OpenwaterHealth/opw_ustx/embedded/README.md

# Openwater USTX Embedded Repository

## Overview

The Openwater USTX Embedded repository is the firmware for the the USTX embedded hardware based on a ST Microelectronics STM32F446 MCU and Texa Instruments TX7332 ultrasound analog front-end (AFE), the USTX is capable of:

- Real-time signal processing: On-board processing for efficient data analysis and filtering.
- Reliable communication: Secure data transmission through various communication protocols.
- Flexible configuration: Adaptable to different underwater applications through software adjustments.

## Getting Started:

1. Clone the repository: git clone https://github.com/OpenwaterHealth/opw_ustx.git
2. Install dependencies: https://www.st.com/en/development-tools/stm32cubeide.html
3. Build the firmware: Import the project source into the STM32 CubeIDE environment and compile the project firmware located in the embedded folder.

## Contribution Guide

For more information on how to contribute to the project, please refer to the [Contribution Guide](CONTRIBUTING.md).
