OpenwaterHealth/opw_ustx/hardware/USTX prototype.docx

USTX prototype

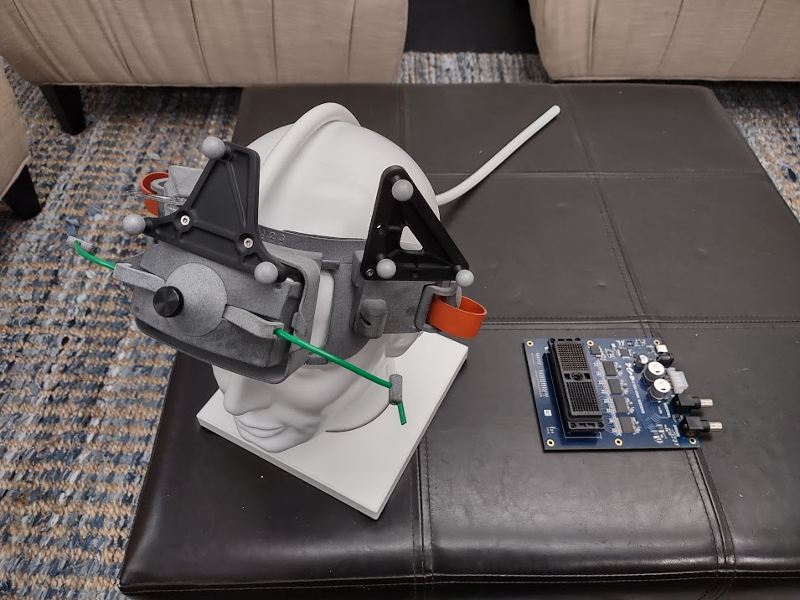
[picture p1: figure]

Figure 1

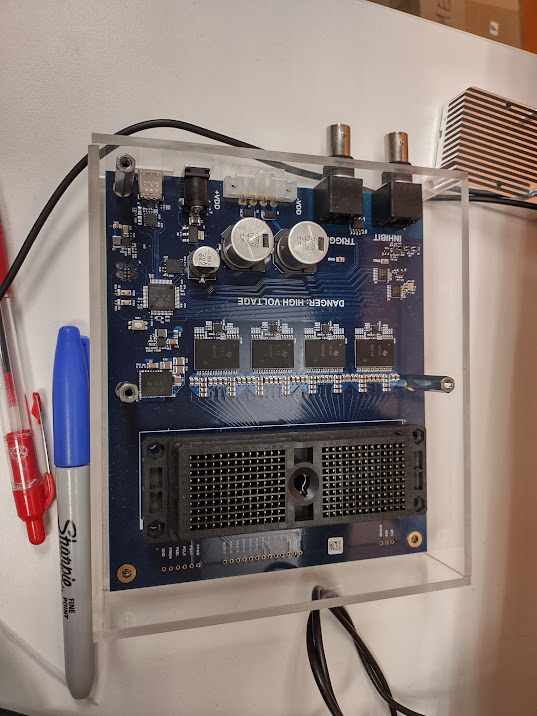
[picture p2: figure]

Figure 2

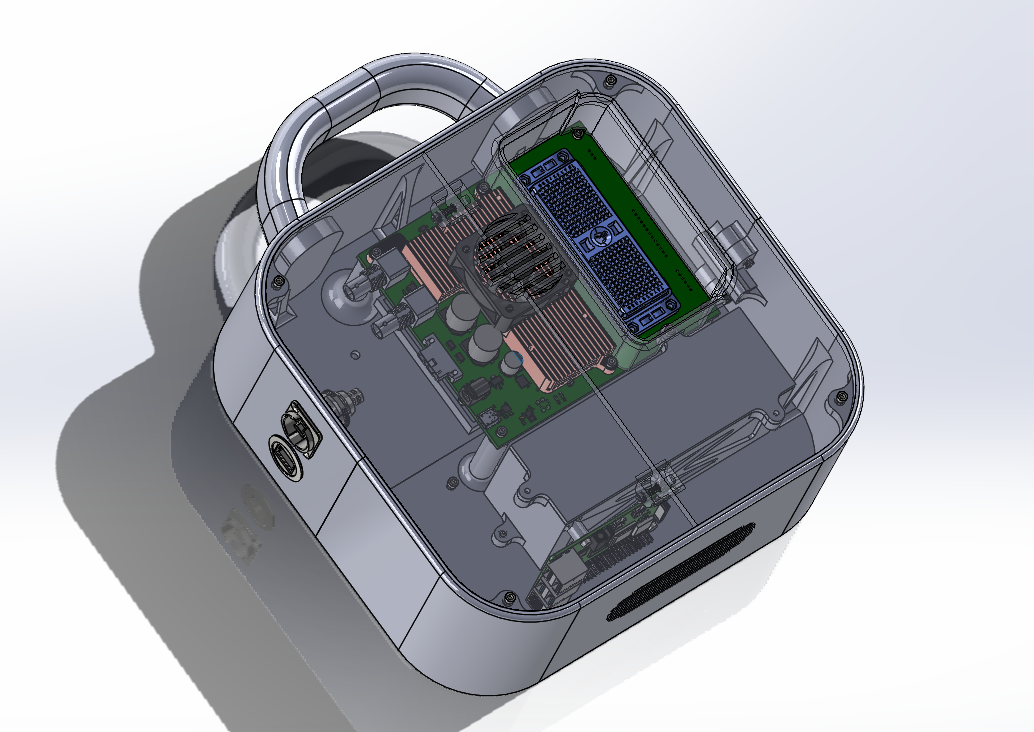
[picture p3: figure]

Figure 3

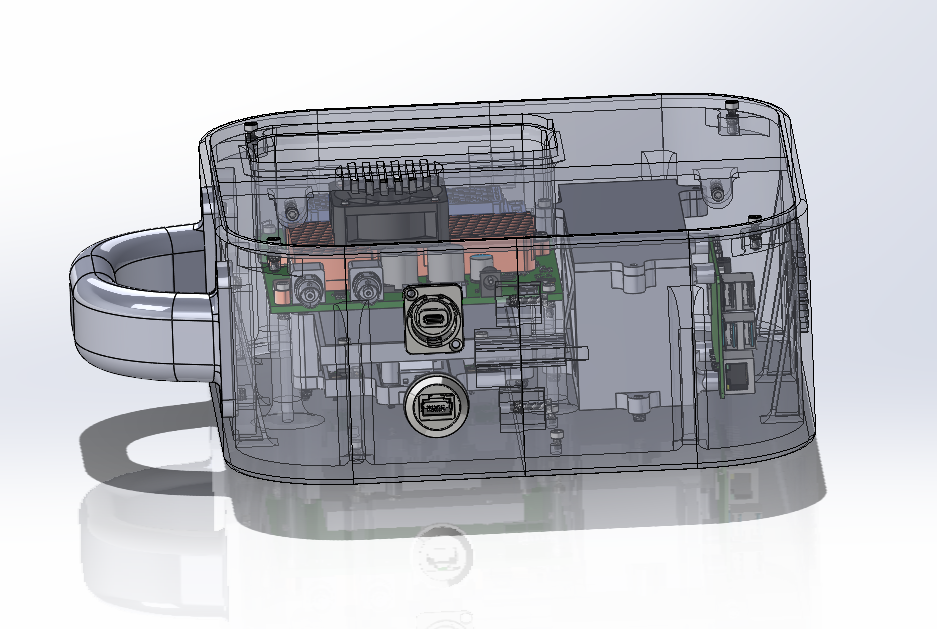
[picture p4: figure]

Figure 4

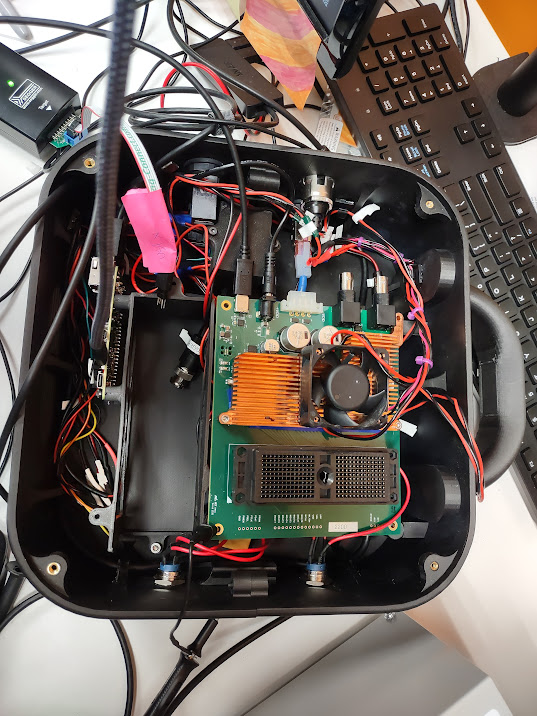
[picture p5: figure]

Figure 5 prototype

The USTX 1-2 .zip is the altium file download

Compact USTX driuper.zip is a compressed file with the native solidworks files

Compact USTX .step is a solid model of the assembly

Compact USTX.easm is a e-drawing or an assembly that can be opened with a free viewer
