OpenwaterHealth/opw_ustx/hardware/Schematic PDF_[No Variations].pdf

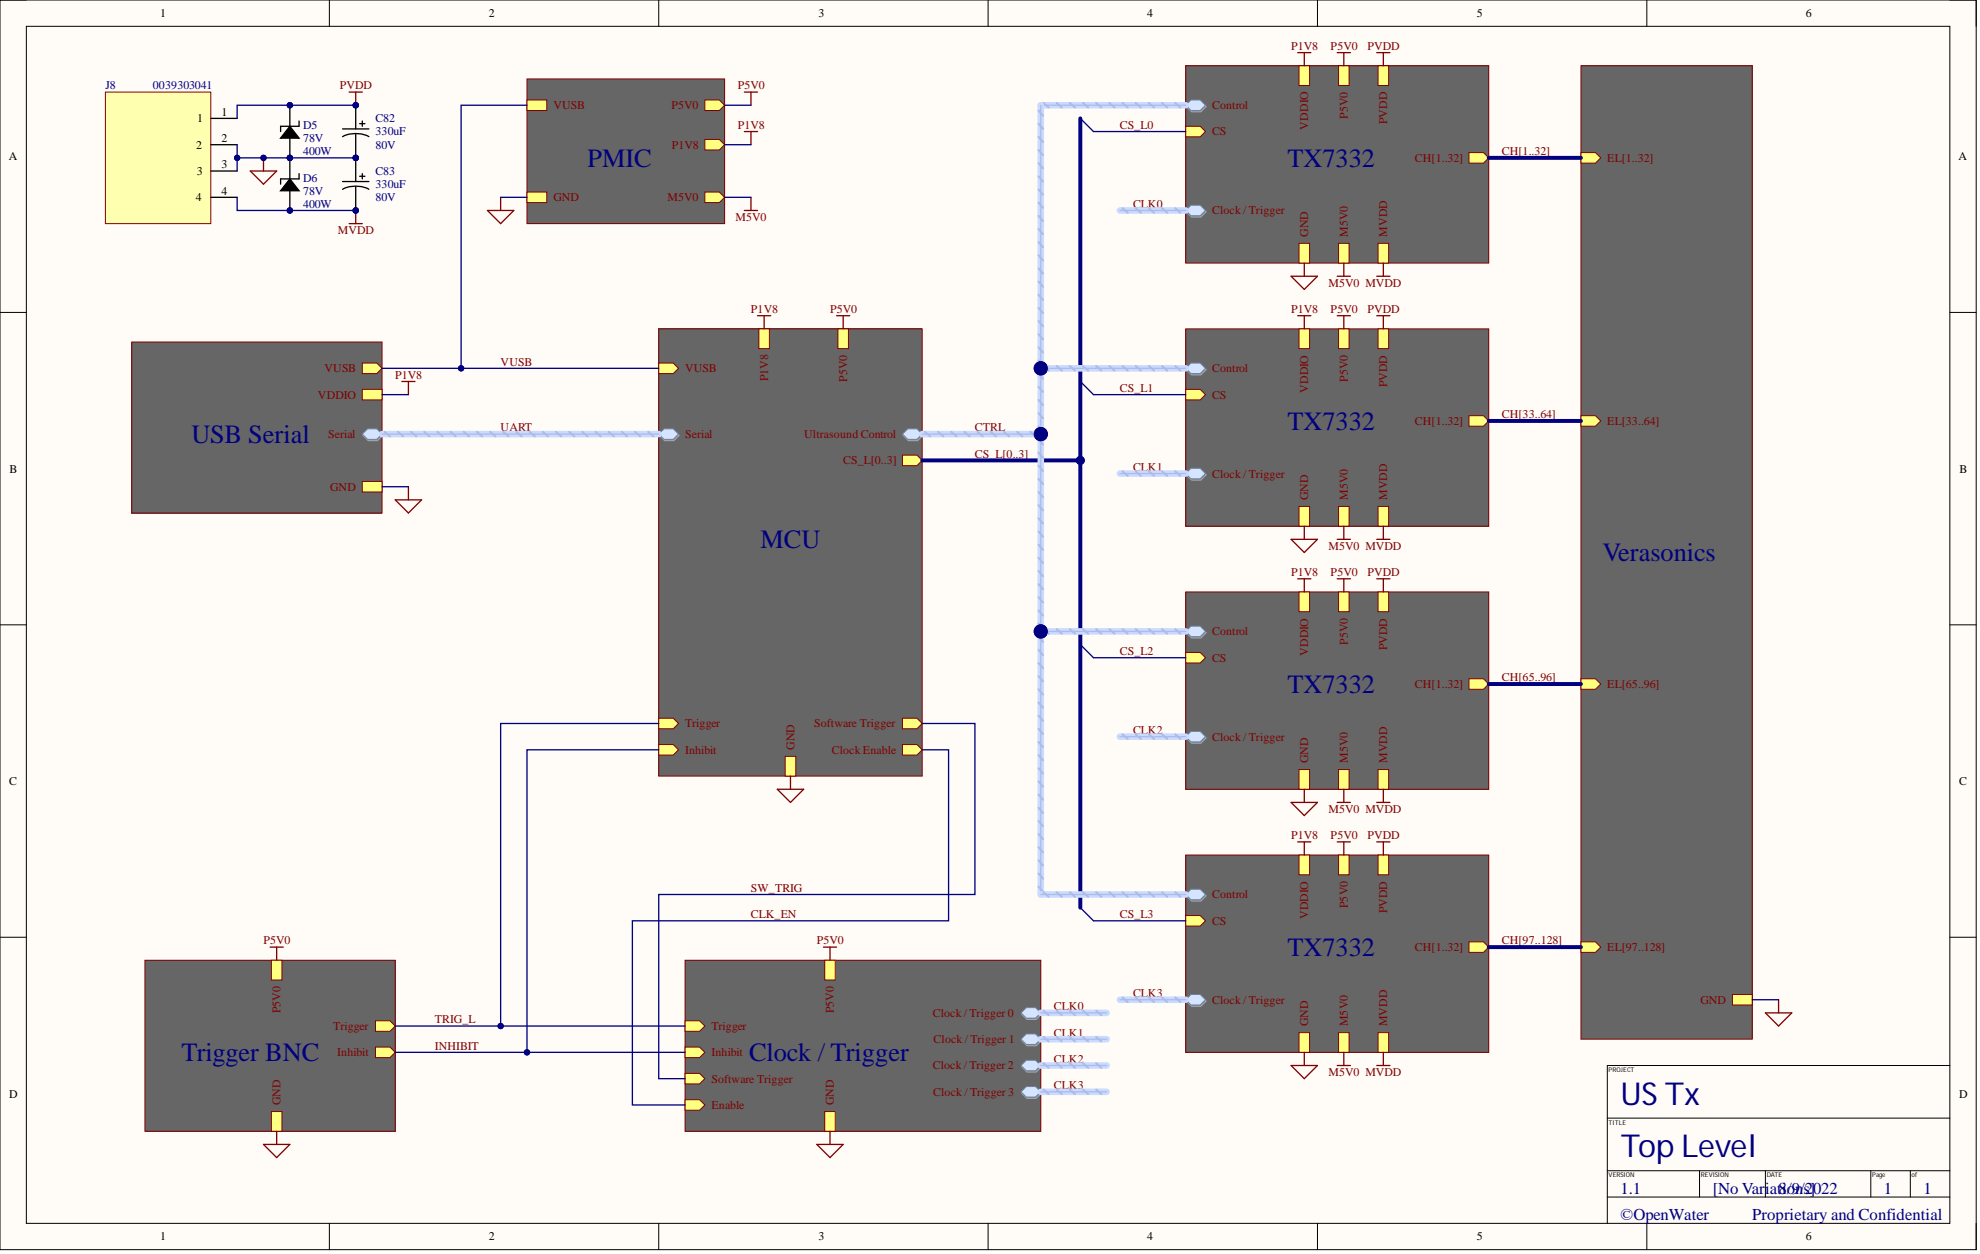
[picture p6: page 1]
Top Level; USB Serial; Ultrasound Control; Inhibit; Clock Enable; Software Trigger; Clock / Trigger; Inhibit rigger BNC; GND P5V0; Clock / Trigger 0; Clock / Trigger 1; Clock / Trigger 2; Clock / Trigger 3

[No Variations] DATE

Proprietary and Confidential

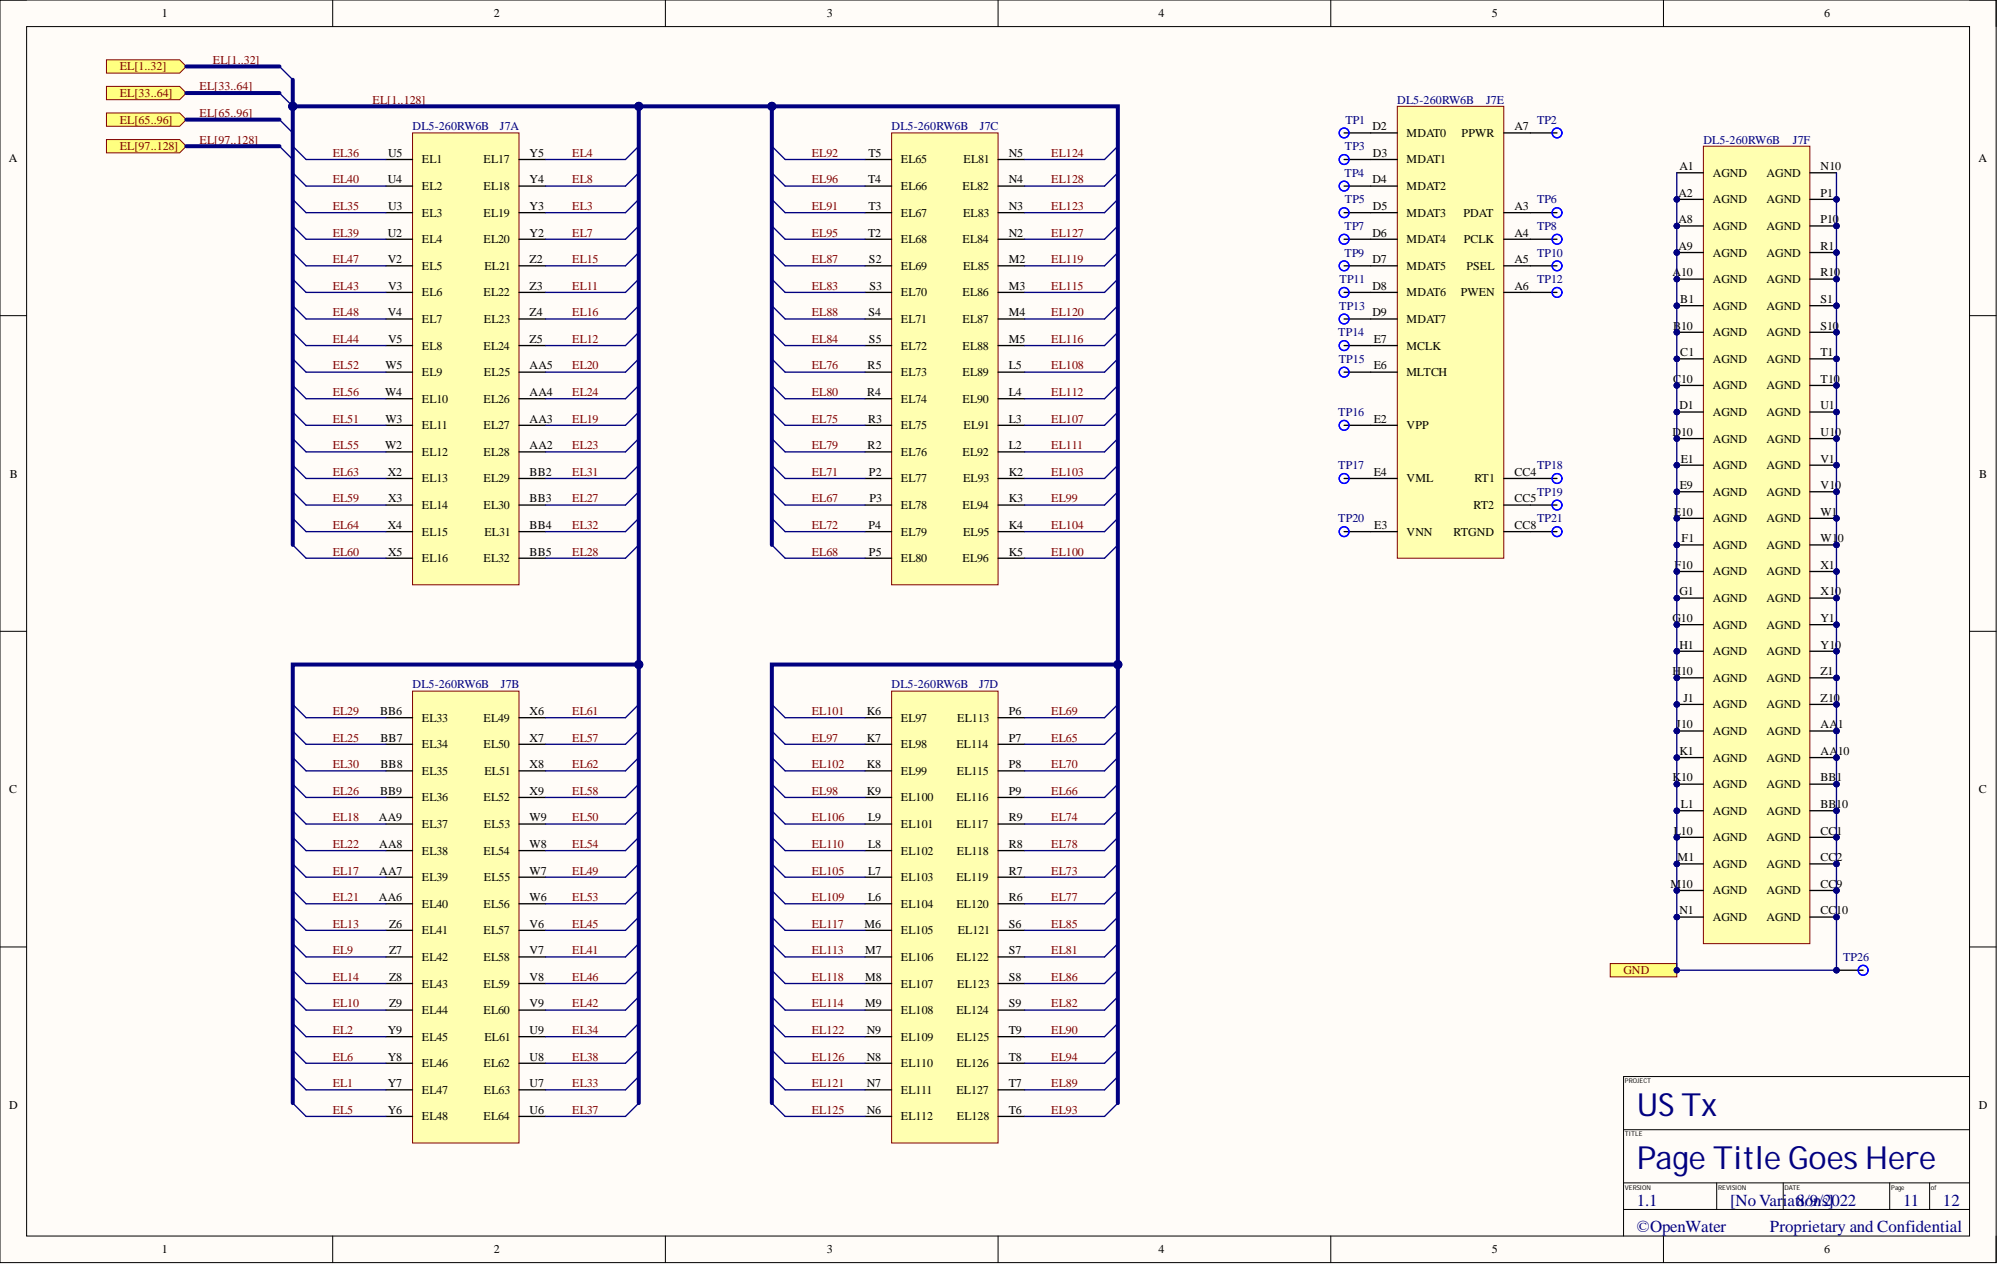
[picture p7: page 2]

PIJ70B10 | 0

PIJ70C1 | T 1

PIJ70C10 | T 1 | 0

PIJ70D1 | U 1

PIJ70D10 | U 1

PIJ70E1 | V 1

PIJ70E9 | V 1

PIJ70E10 | W 1

PIJ70F1 | W 1

PIJ70F10 | X 1

PIJ70G1 | X 1

PIJ70G10 | Y 1

PIJ70H1 | Y 1

PIJ70H10 | Z 1

PIJ70J1 PIJ70J1 PIJ70J10 PIJ70J10 | A A

PIJ70K1 | A A

TITLE
Page Title Goes Her

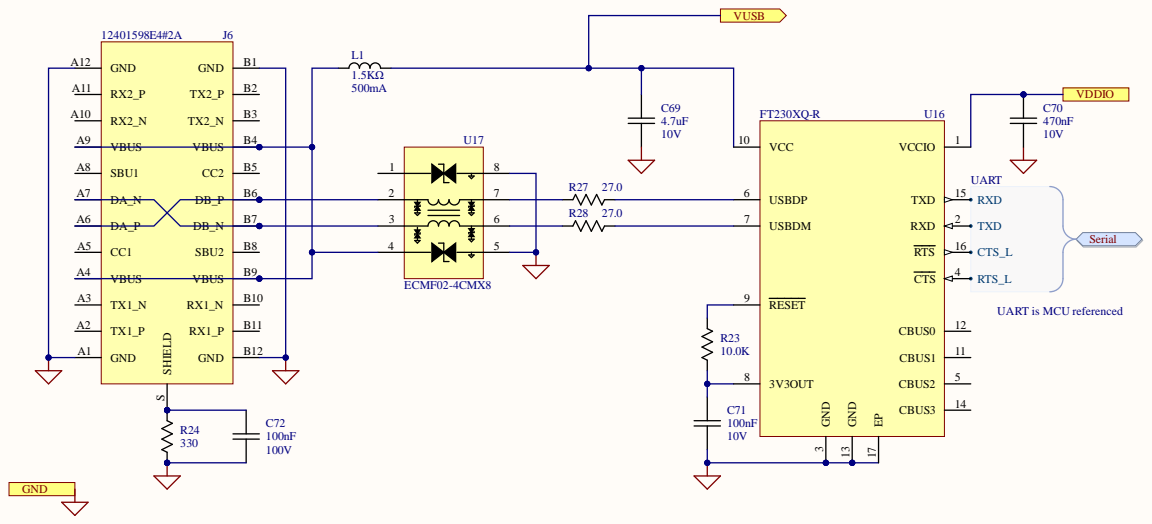
[picture p8: page 3]

UART is MCU referenced

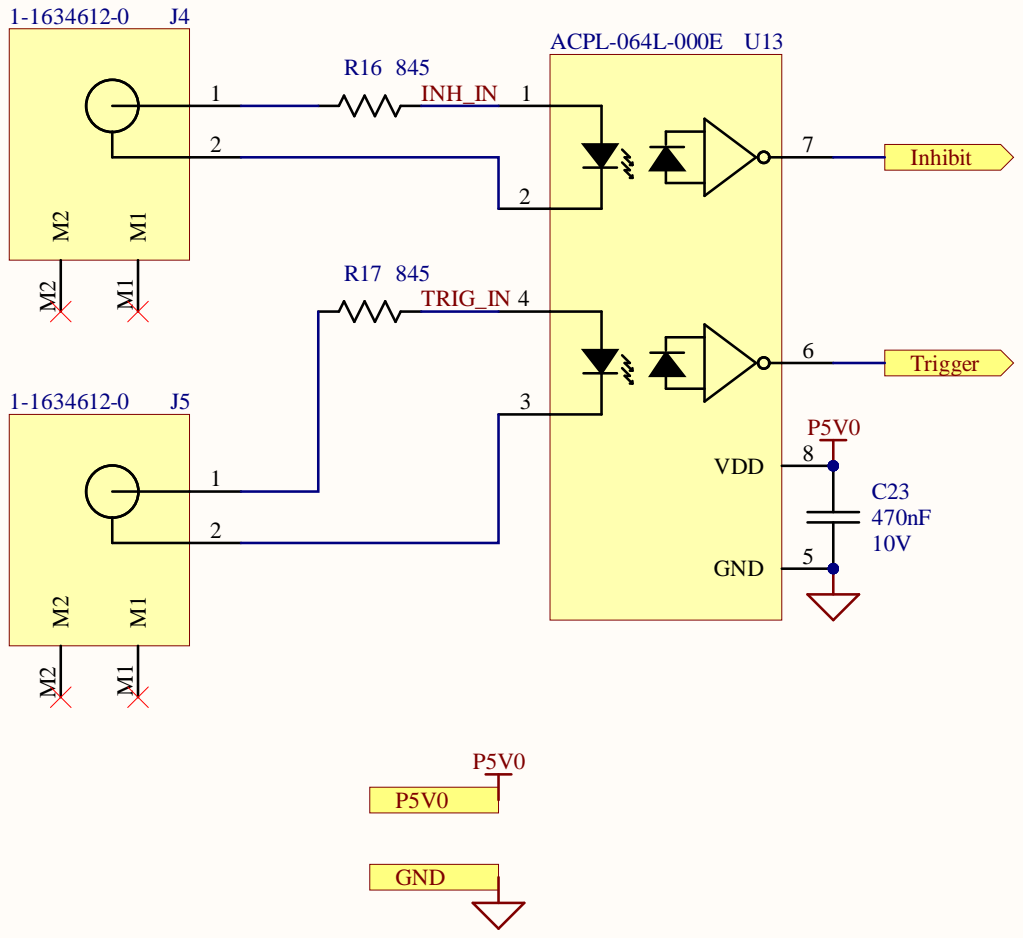
[picture p9: page 4]
Trigger In

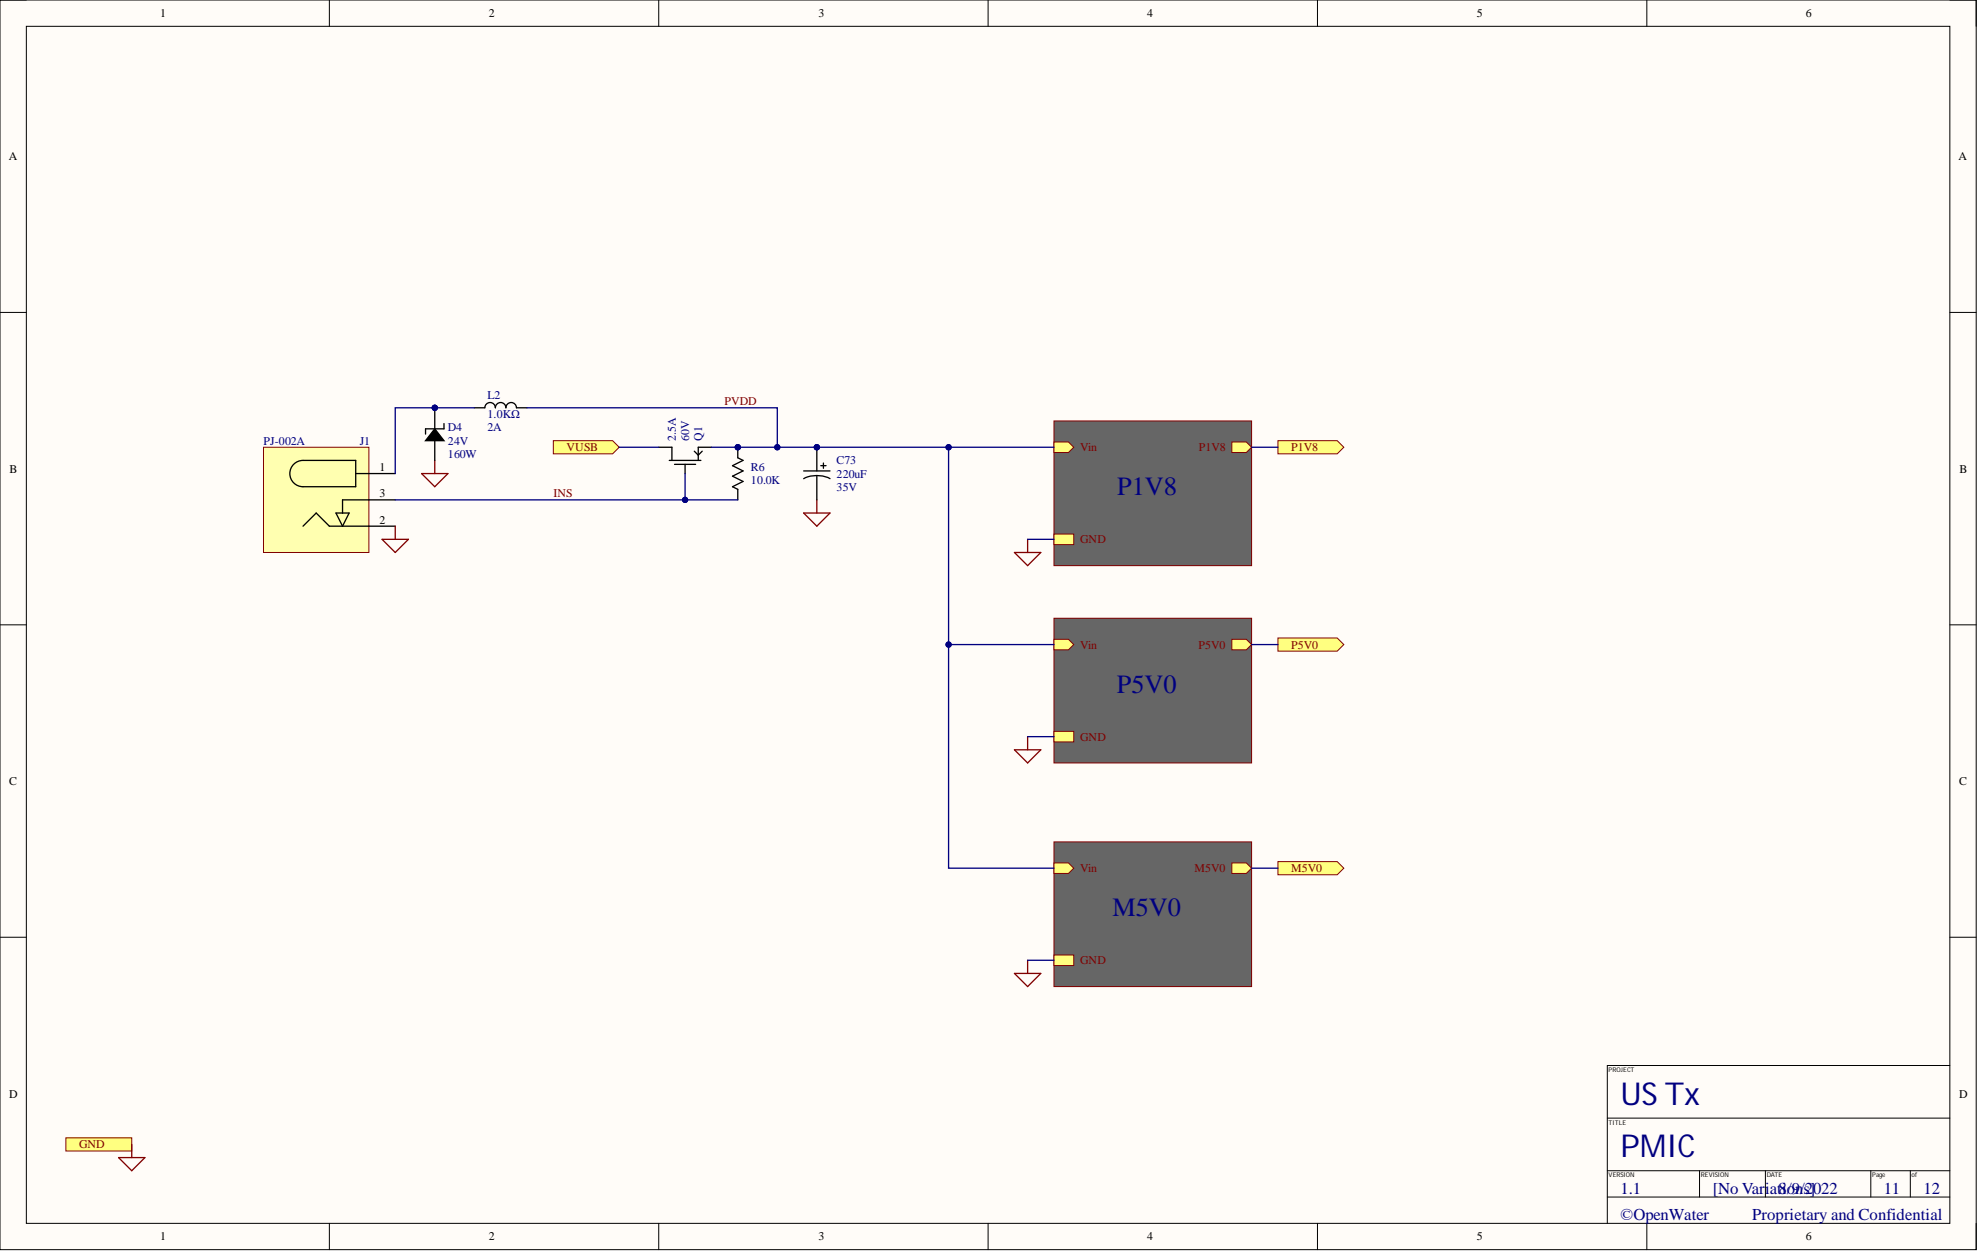
[picture p10: page 5]

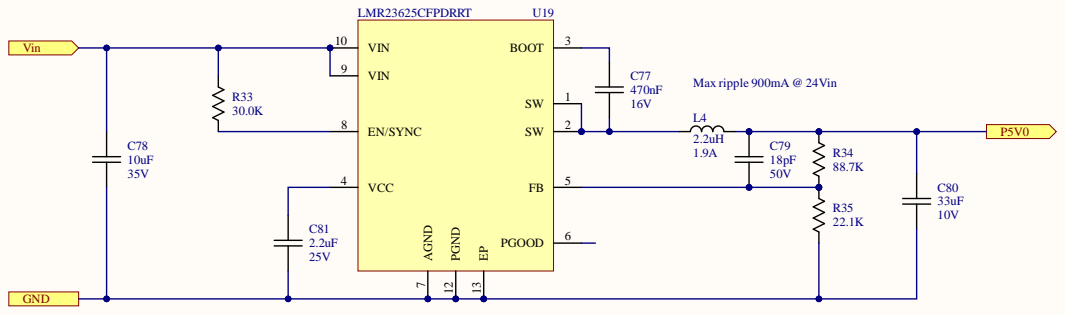
[picture p11: page 6]

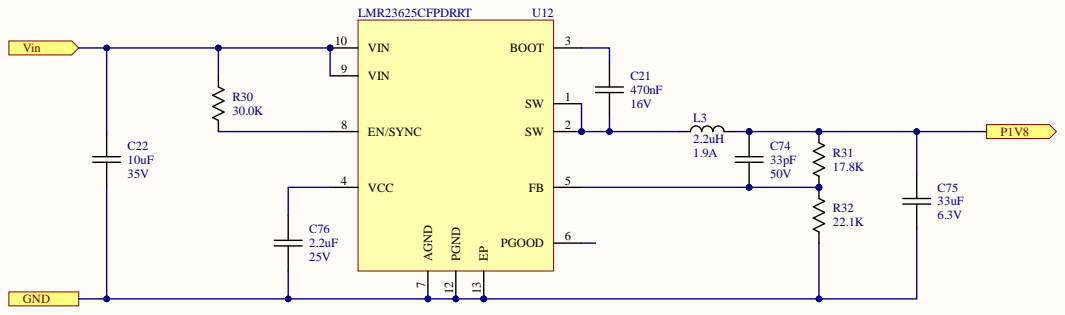
[picture p12: page 7]

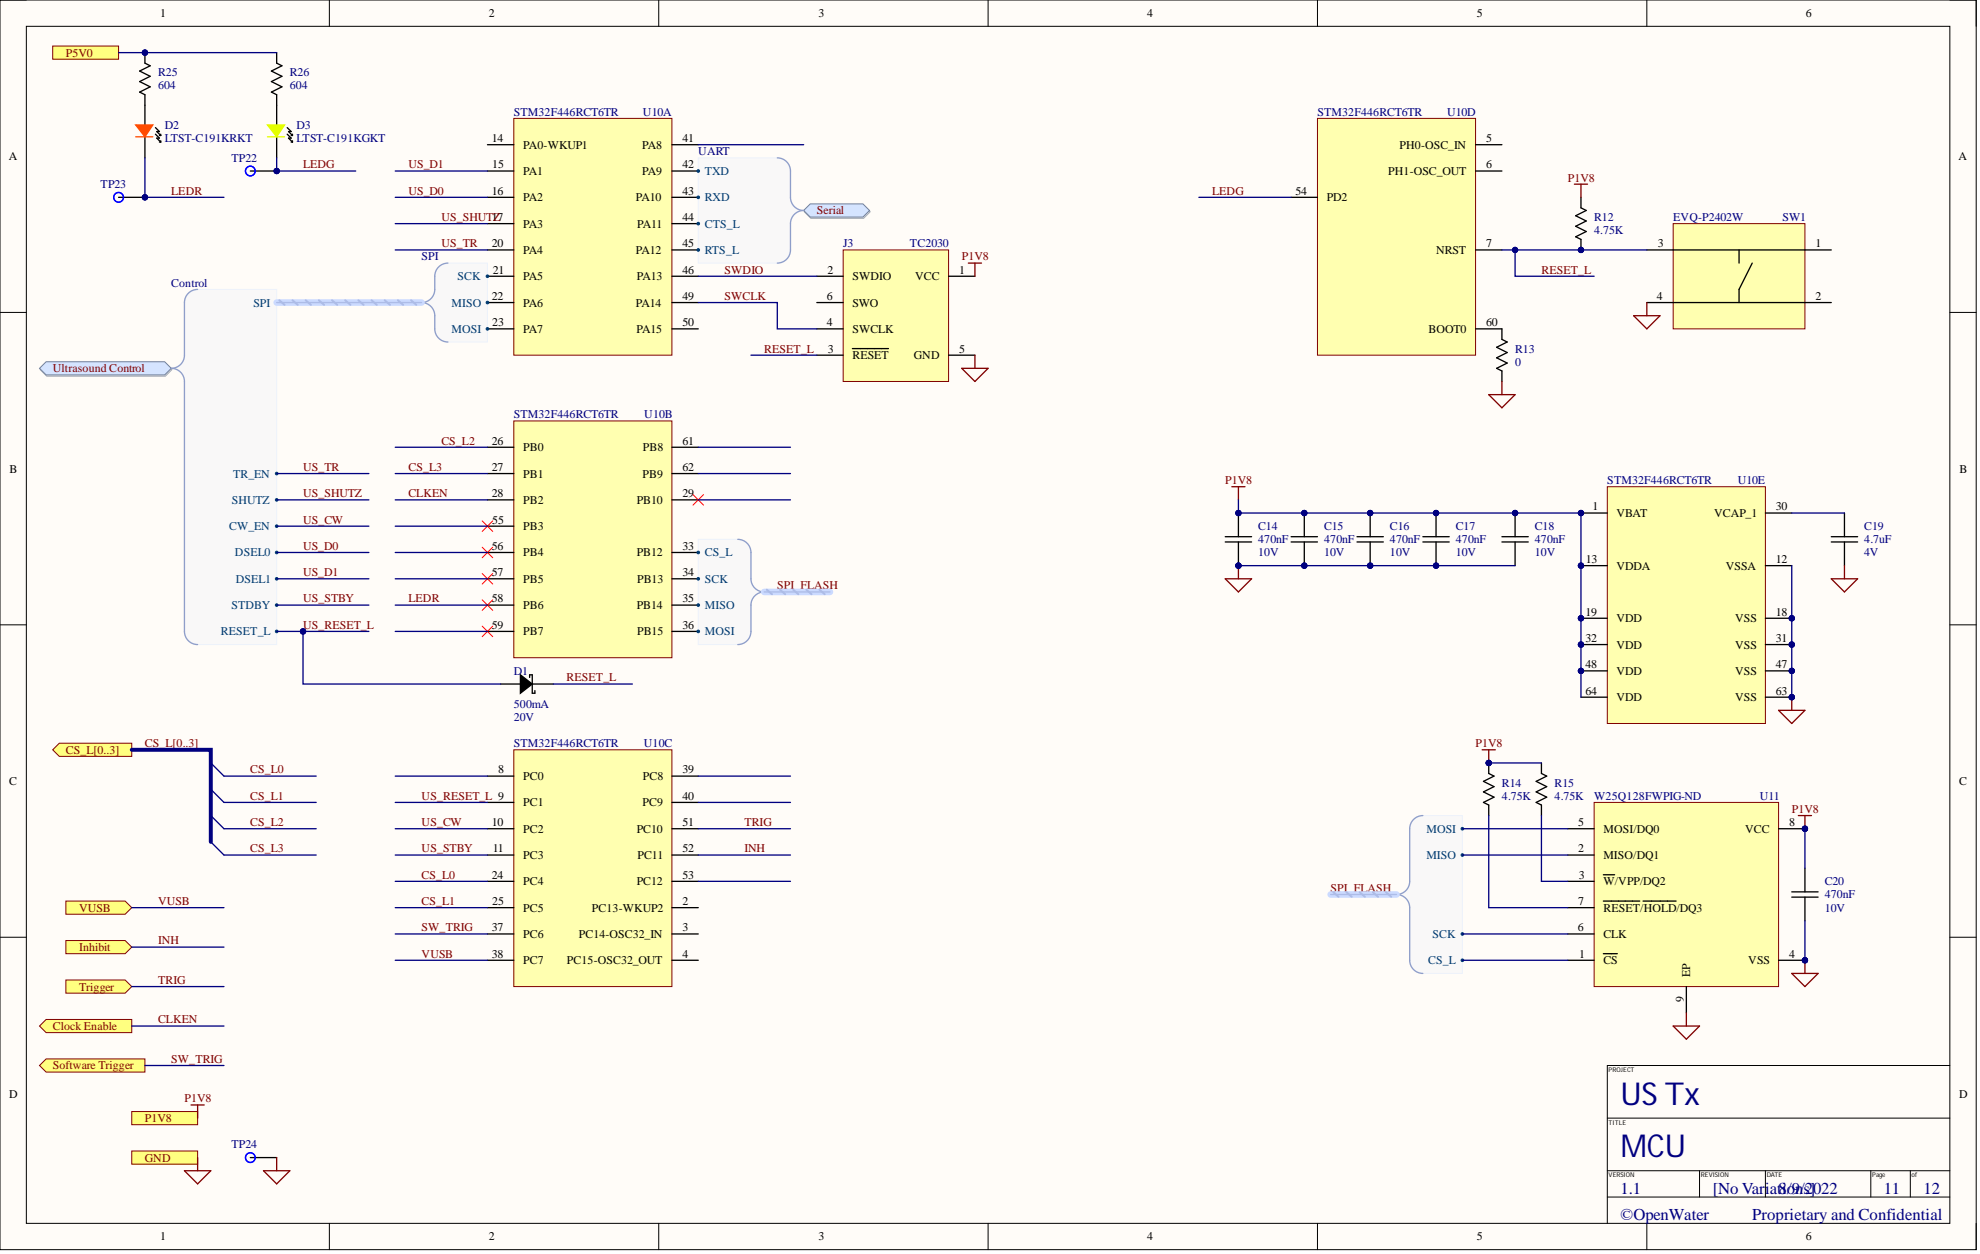
[picture p13: page 8]

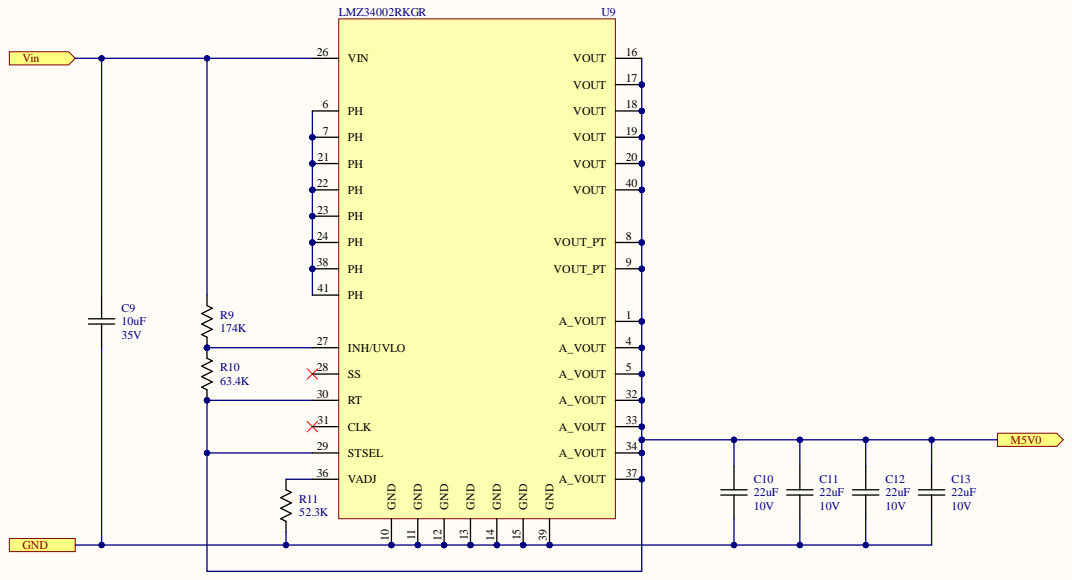
[picture p14: page 9]

CLK 31

VADJ 36

PROJECT
Page Title Goes Here

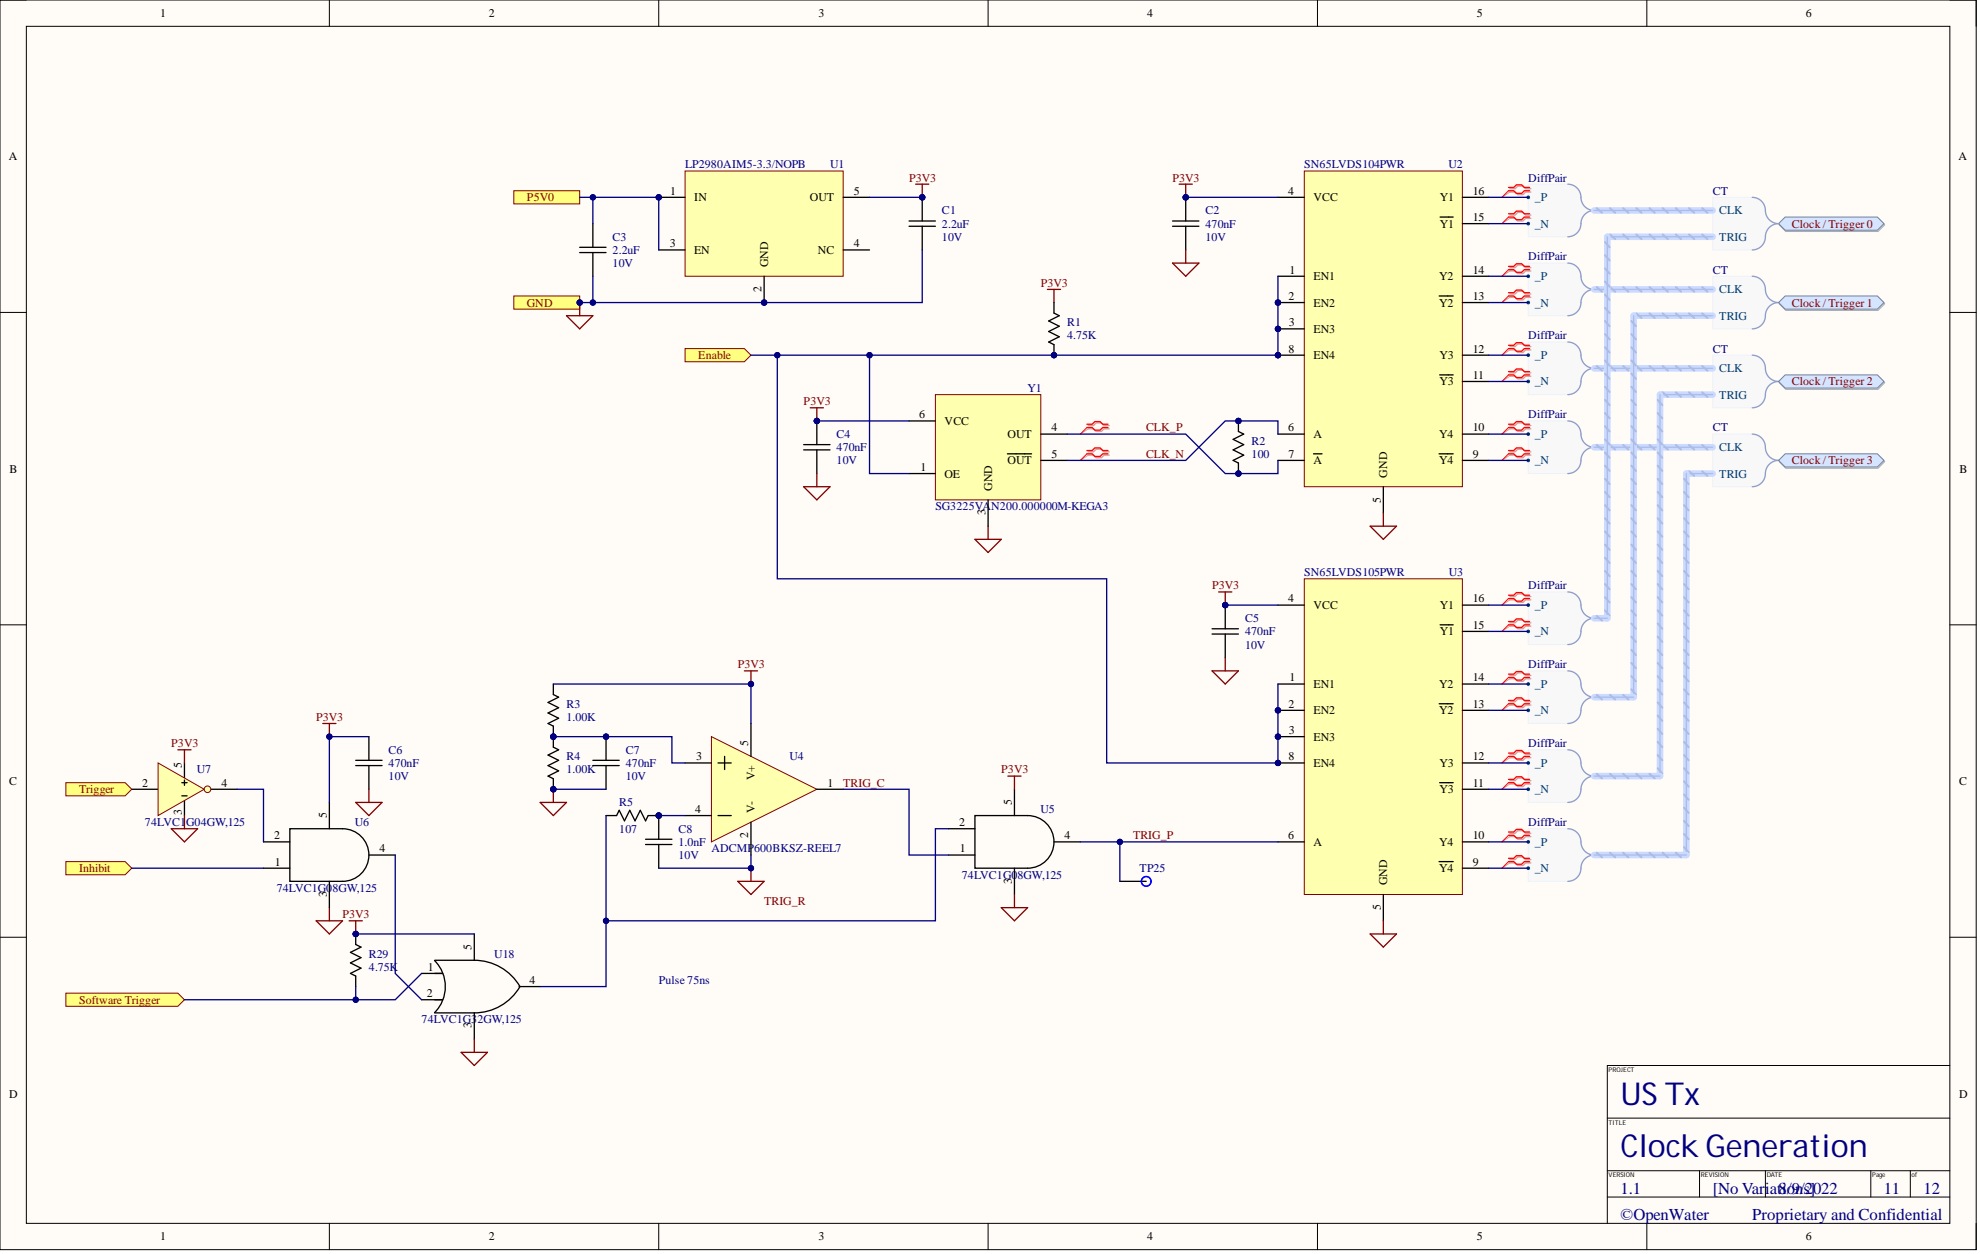
[picture p15: page 10]

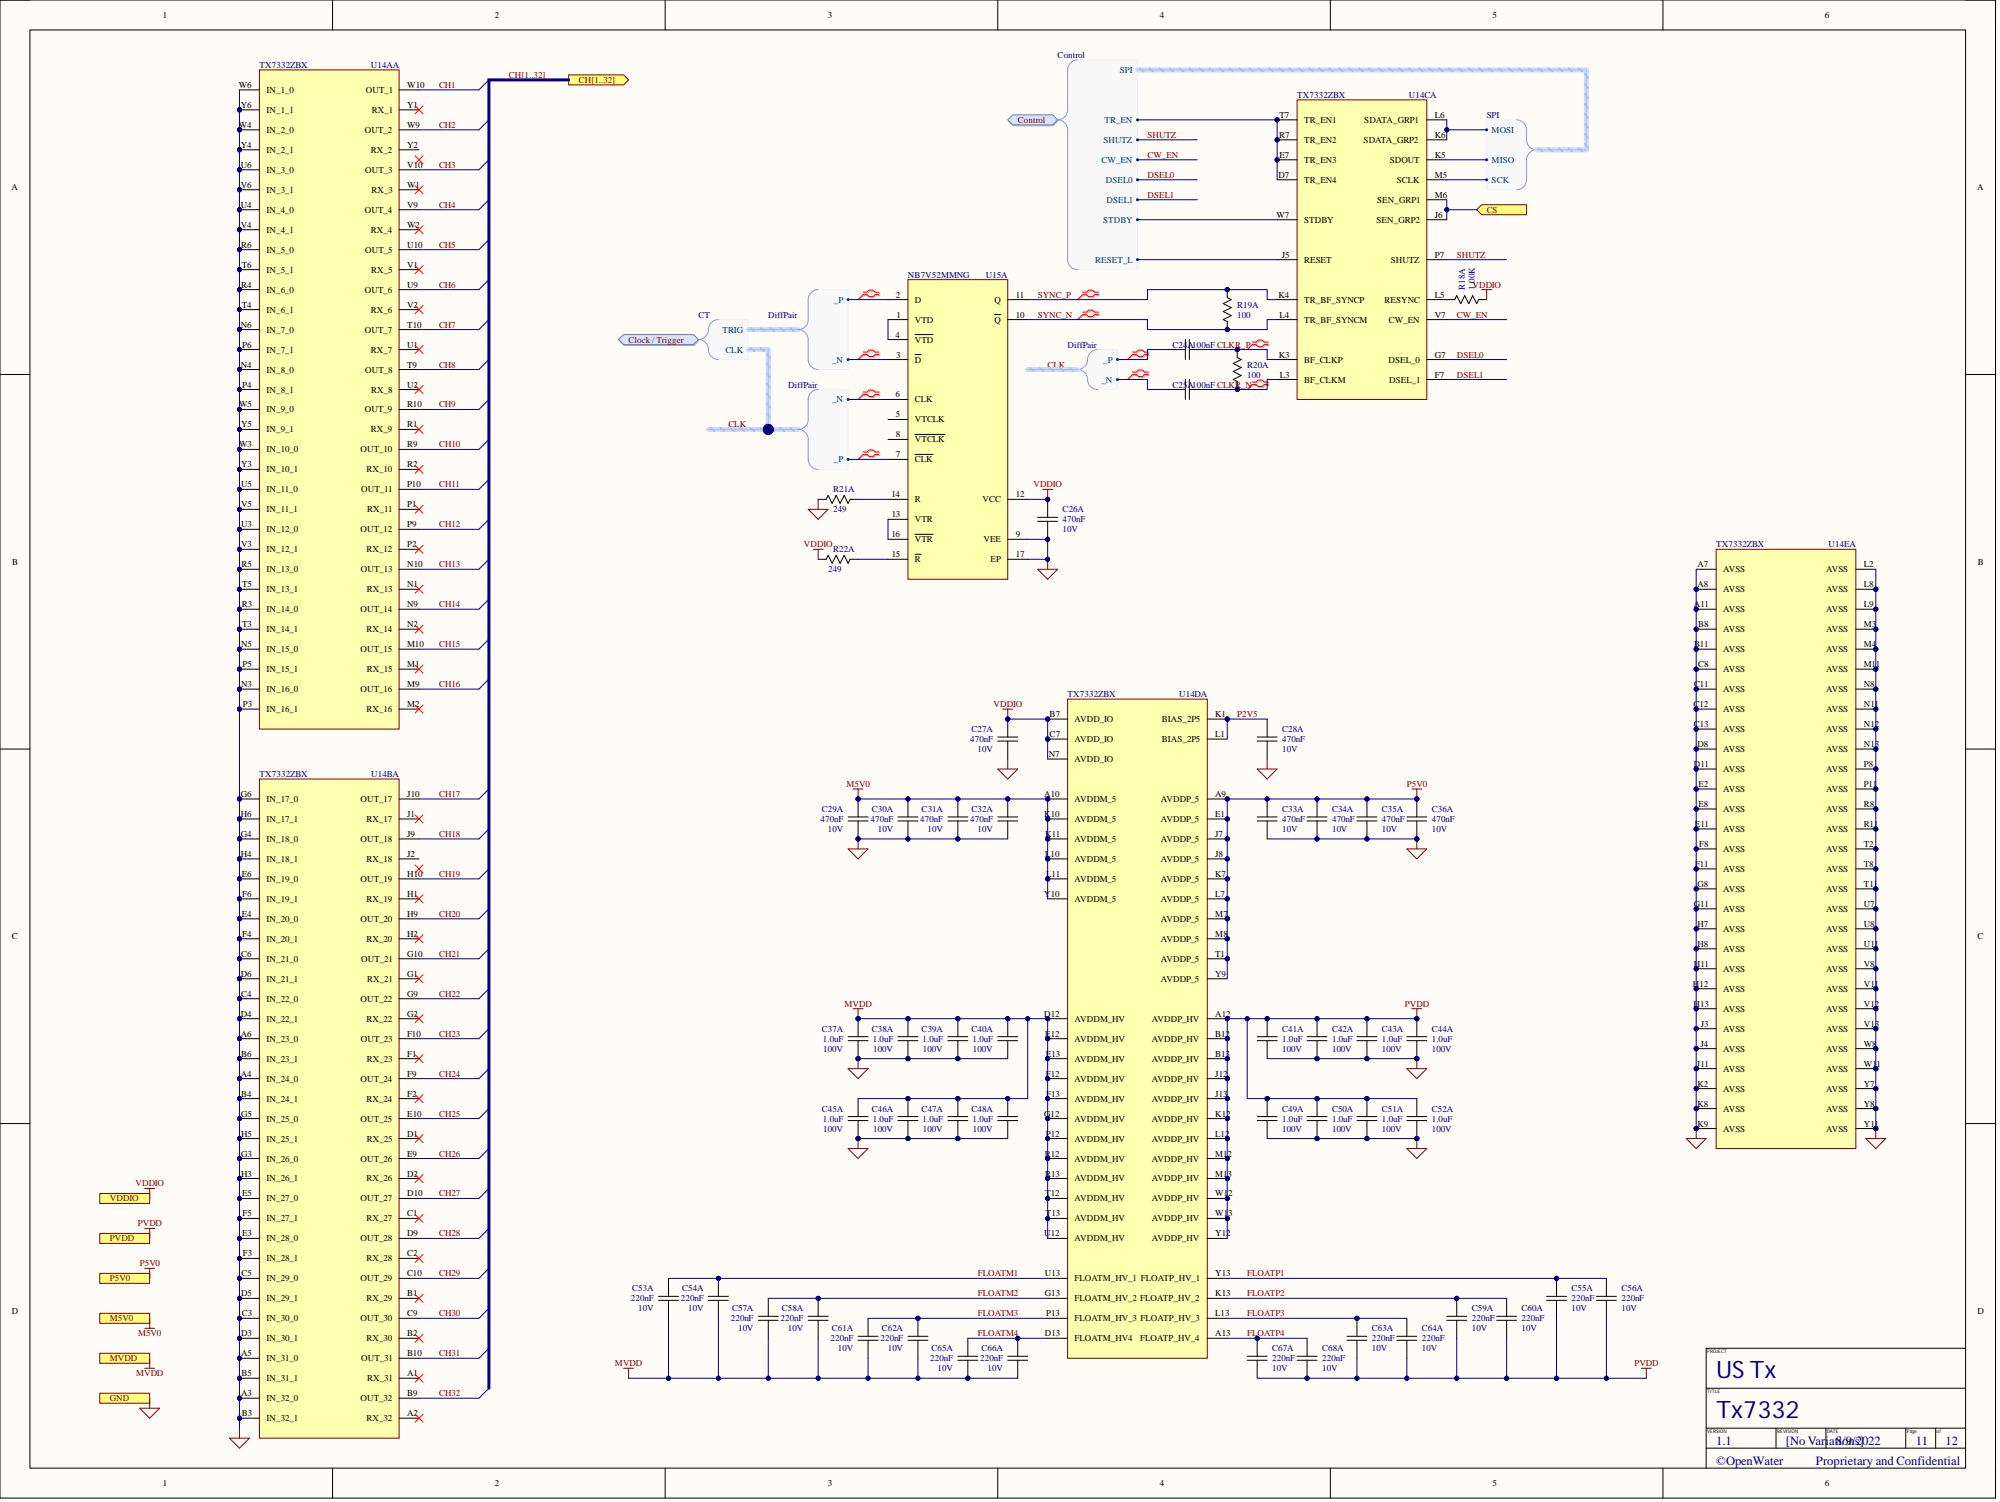
[picture p16: page 11]

POClock 0 Trigger0CLK00NA POClock 0 Trigger0CLK00PA POClock 0 Trigger0CLKA POClock 0 Trigger0TRIG00NA POClock 0 Trigger0TRIG00PA POClock 0 Trigger0TRIGA POClock 0 TriggerA

POClock 0 Trigger0CLK00NB POClock 0 Trigger0CLK00PB POClock 0 Trigger0CLKB POClock 0 Trigger0TRIG00NB POClock 0 Trigger0TRIG00PB POClock 0 Trigger0TRIGB POClock 0 TriggerB

PIU14A0C12 PIU14A0C12 PIU14B0C12 PIU14B0C12 | N 1 | 1

PIC27A01 PIC27A01 PIC27B01 PIC27B01 PIC27C01 | PIU14A0C7 PIU14A0C7 PIU14B0C7 PIU14B0C7 | L 1 | PIC28A01 PIU14A0K1 PIC28B01 PIU14B0K1

PIU14A0C13 PIU14A0C13 PIU14B0C13 PIU14B0C13 | N 1

PIC27A02 PIC27A02 PIC27B02 PIC27B02 PIC27C02 | | | PIC28A02 PIC28A02 PIC28B02 PIC28B02 PIC28C02

PIU14A0H8 PIU14A0H8 PIU14B0H8 PIU14B0H8 PIU14A0H11 PIU14A0H11 PIU14B0H11 PIU14B0H11 | V 8

PIU14A0H12 PIU14A0H12 PIU14B0H12 PIU14B0H12 | V 1 | 1

PIU14A0J4 PIU14A0J4 PIU14B0J4 PIU14B0J4 | W 1

PIU14A0J11 PIU14A0J11 PIU14B0J11 PIU14B0J11 PIU14A0K2 PIU14A0K2 PIU14B0K2 PIU14B0K2 | Y 7

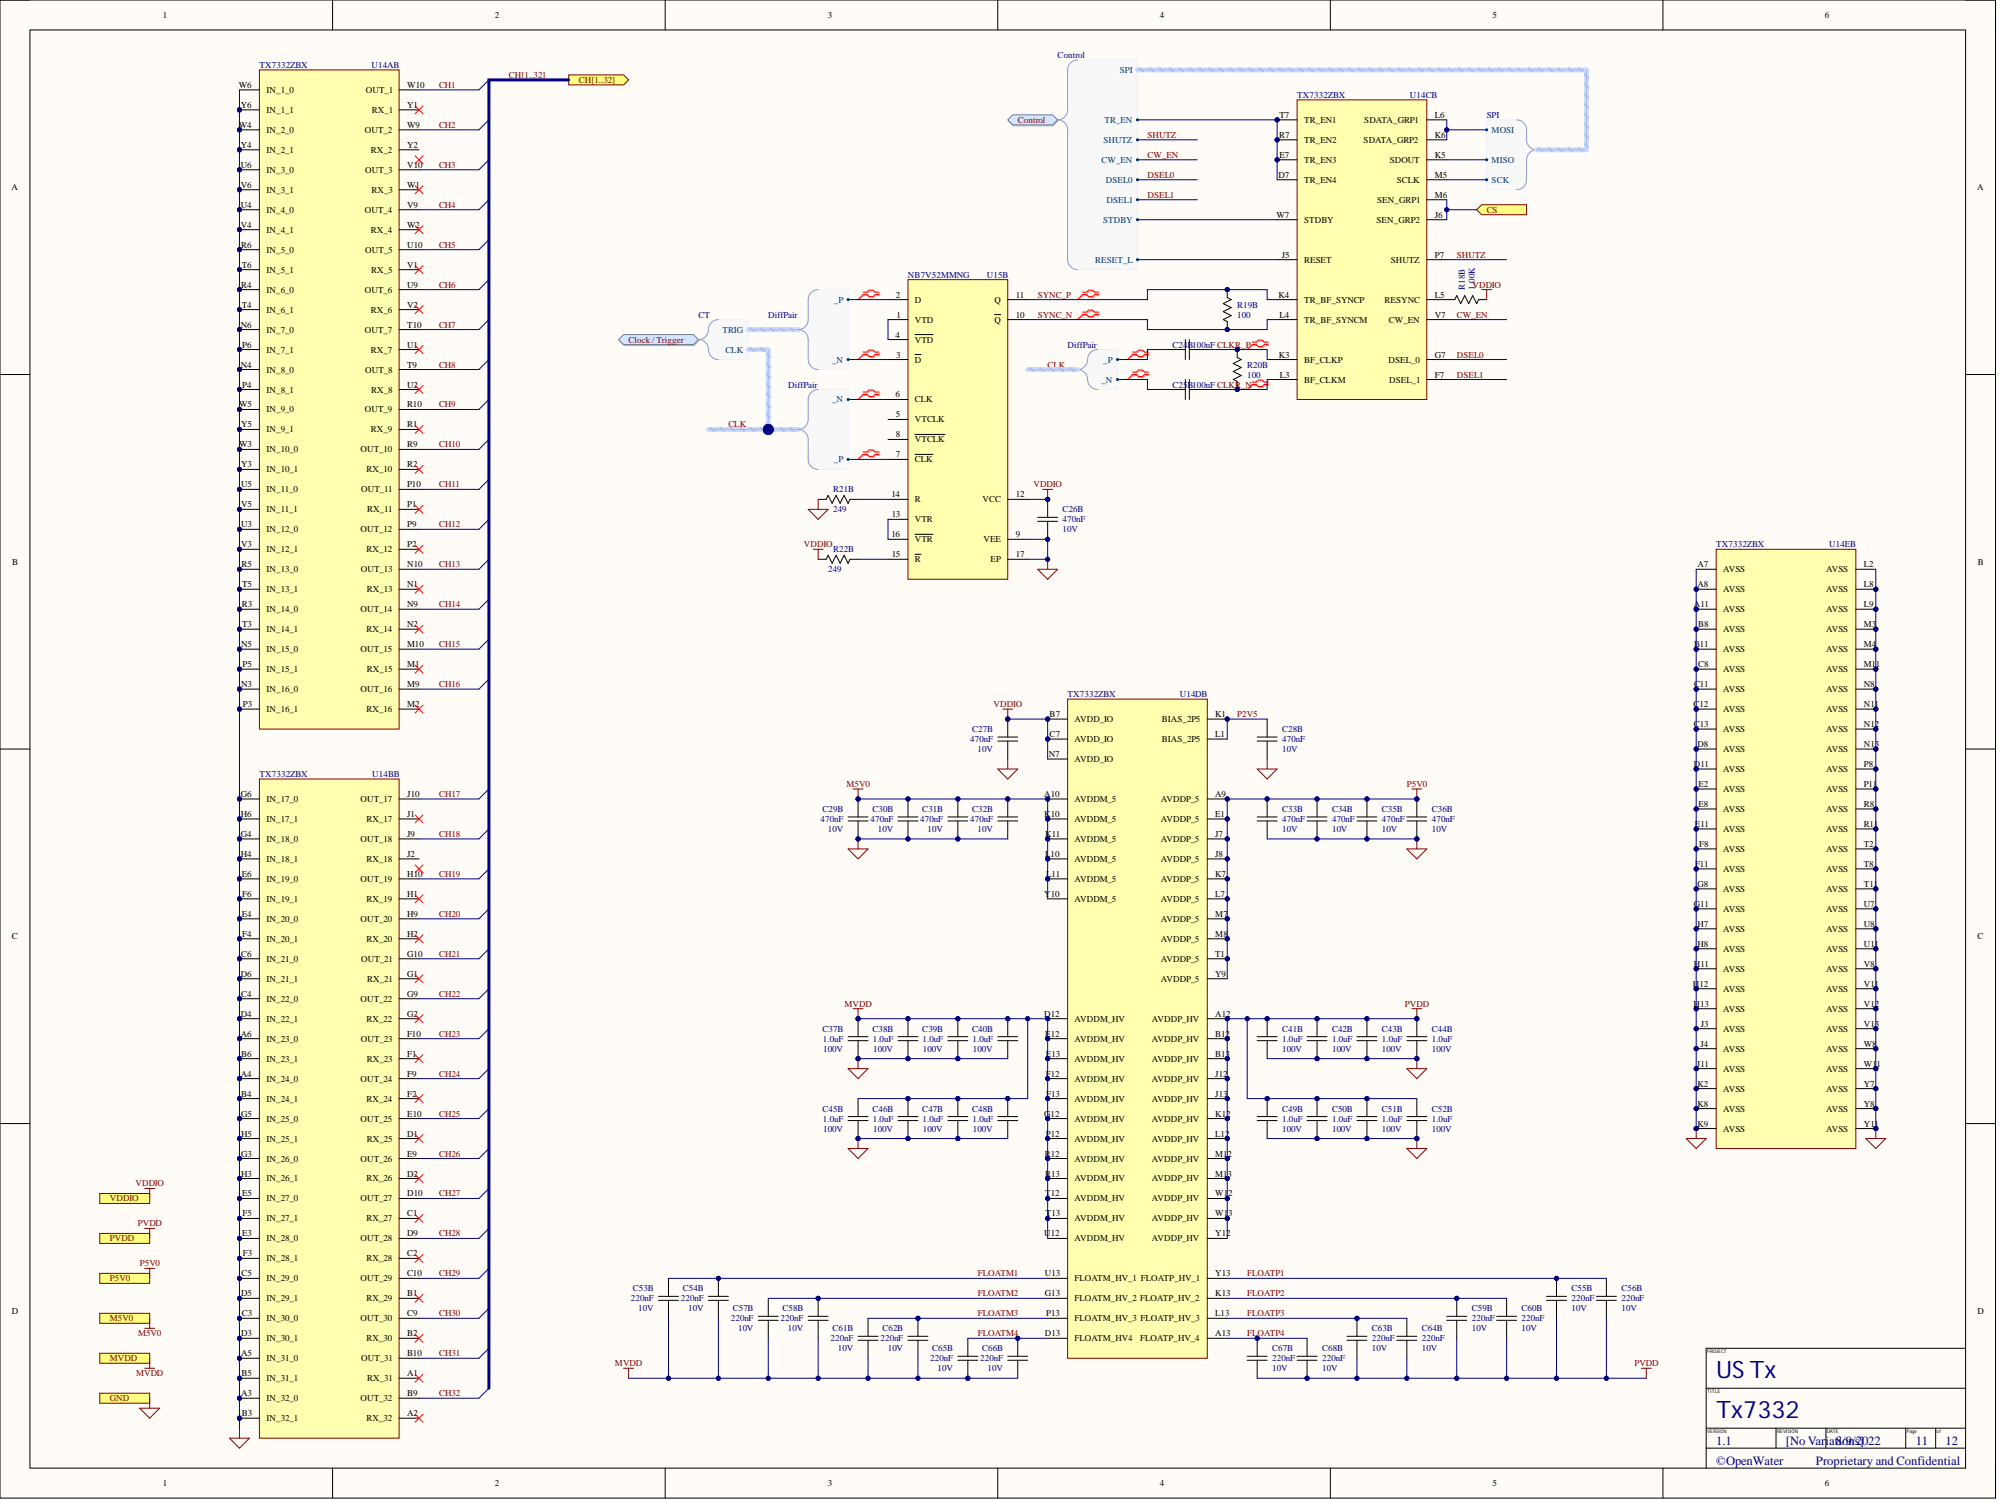
[picture p17: page 12]

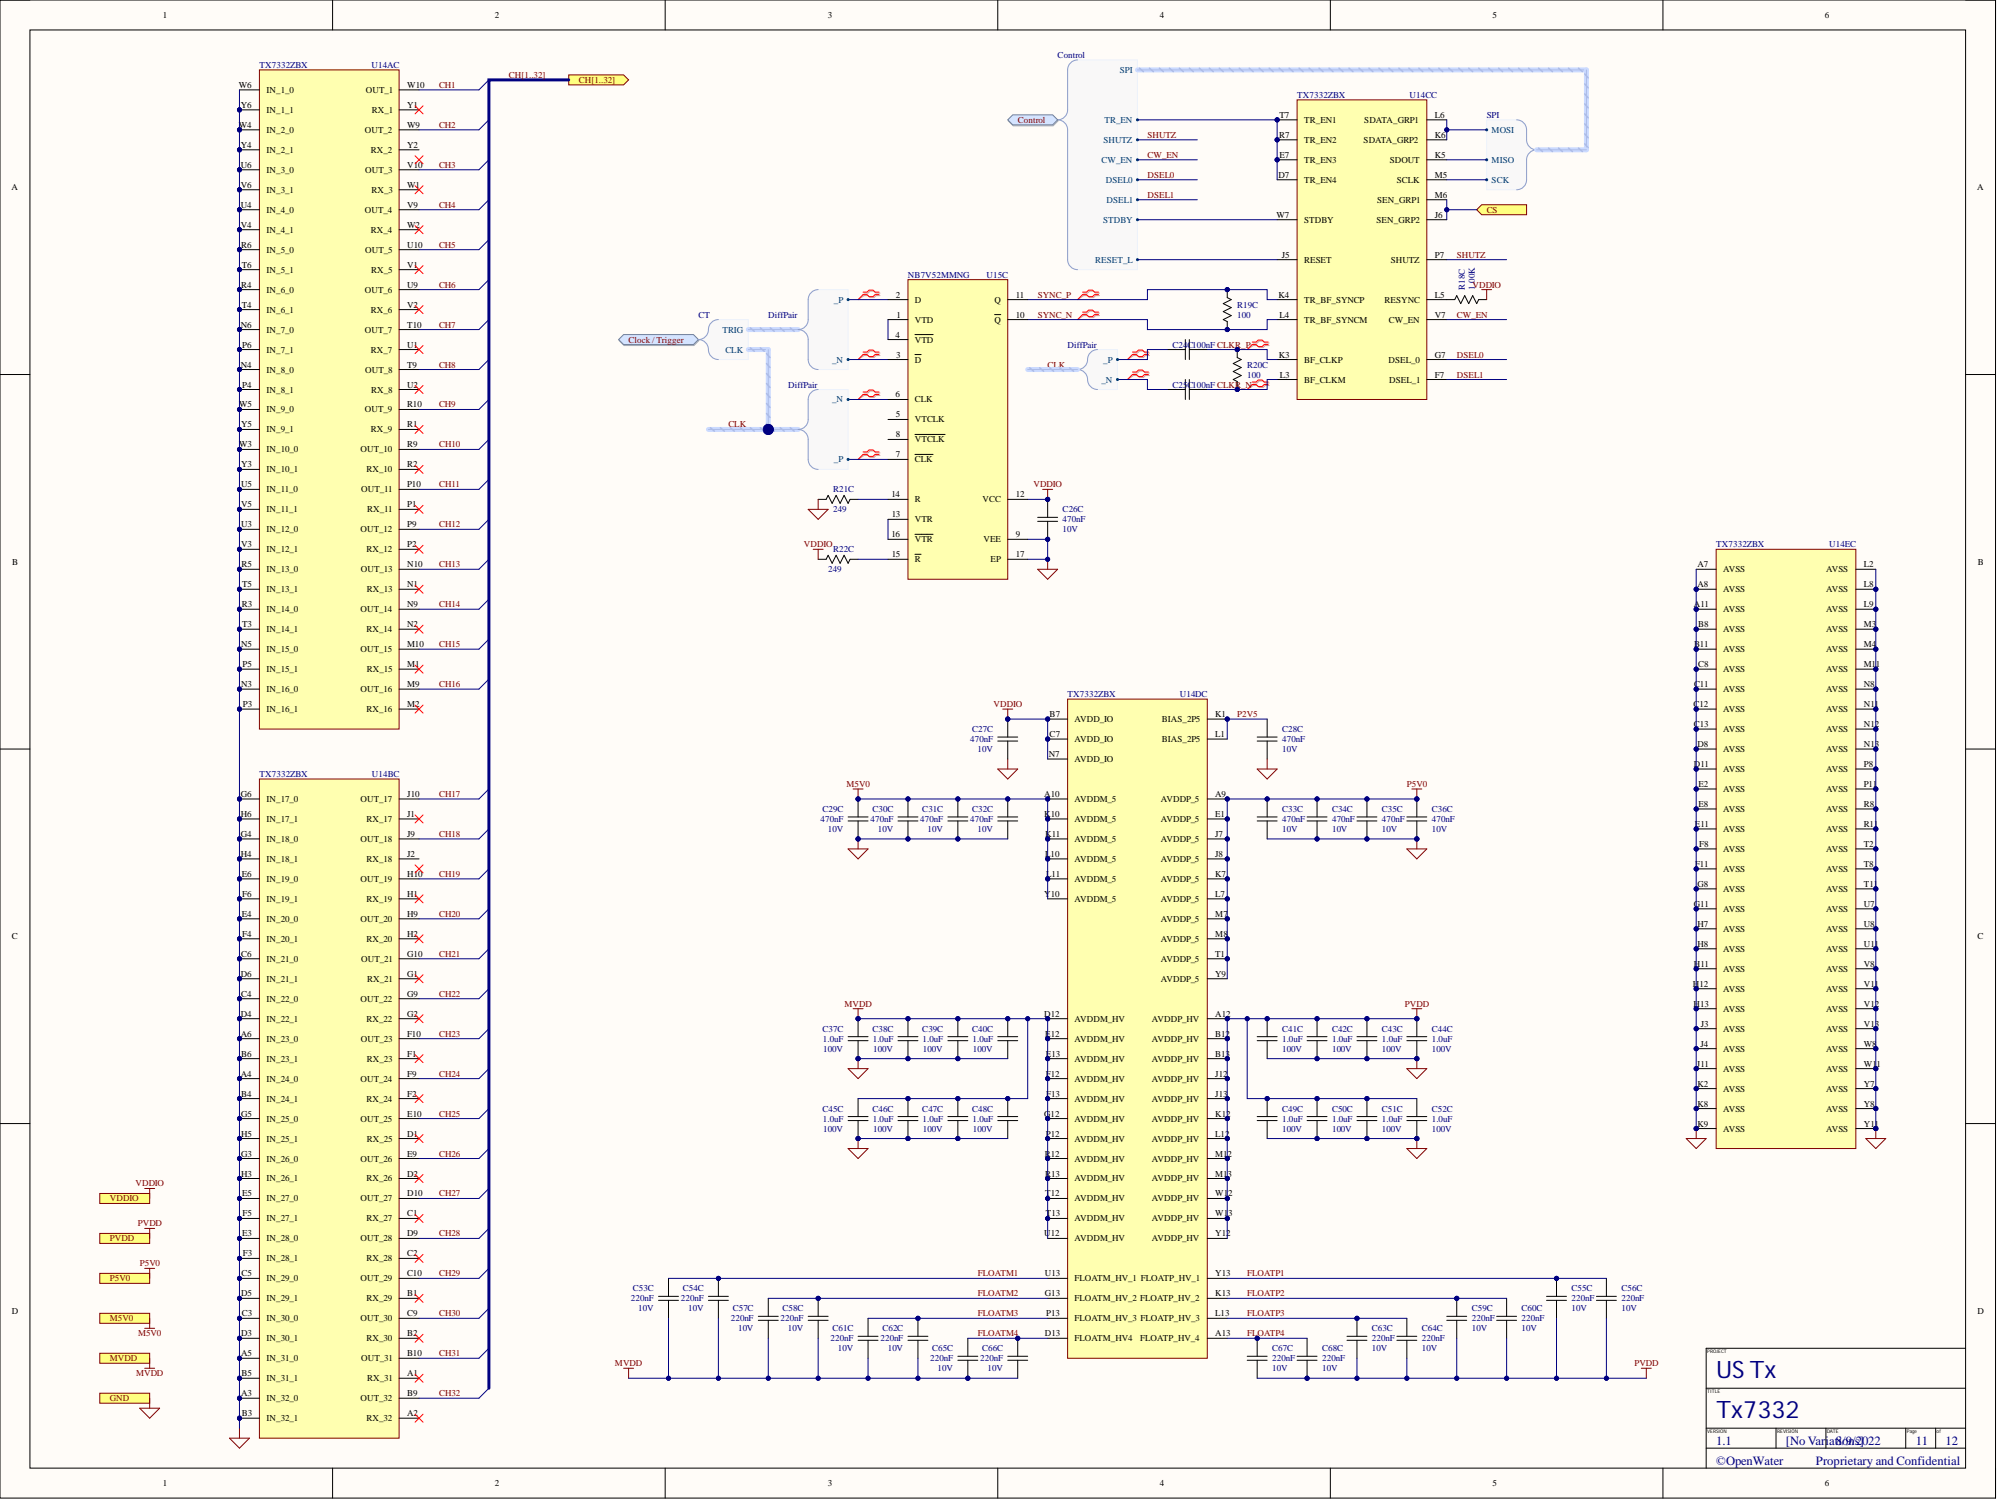
[picture p18: page 13]

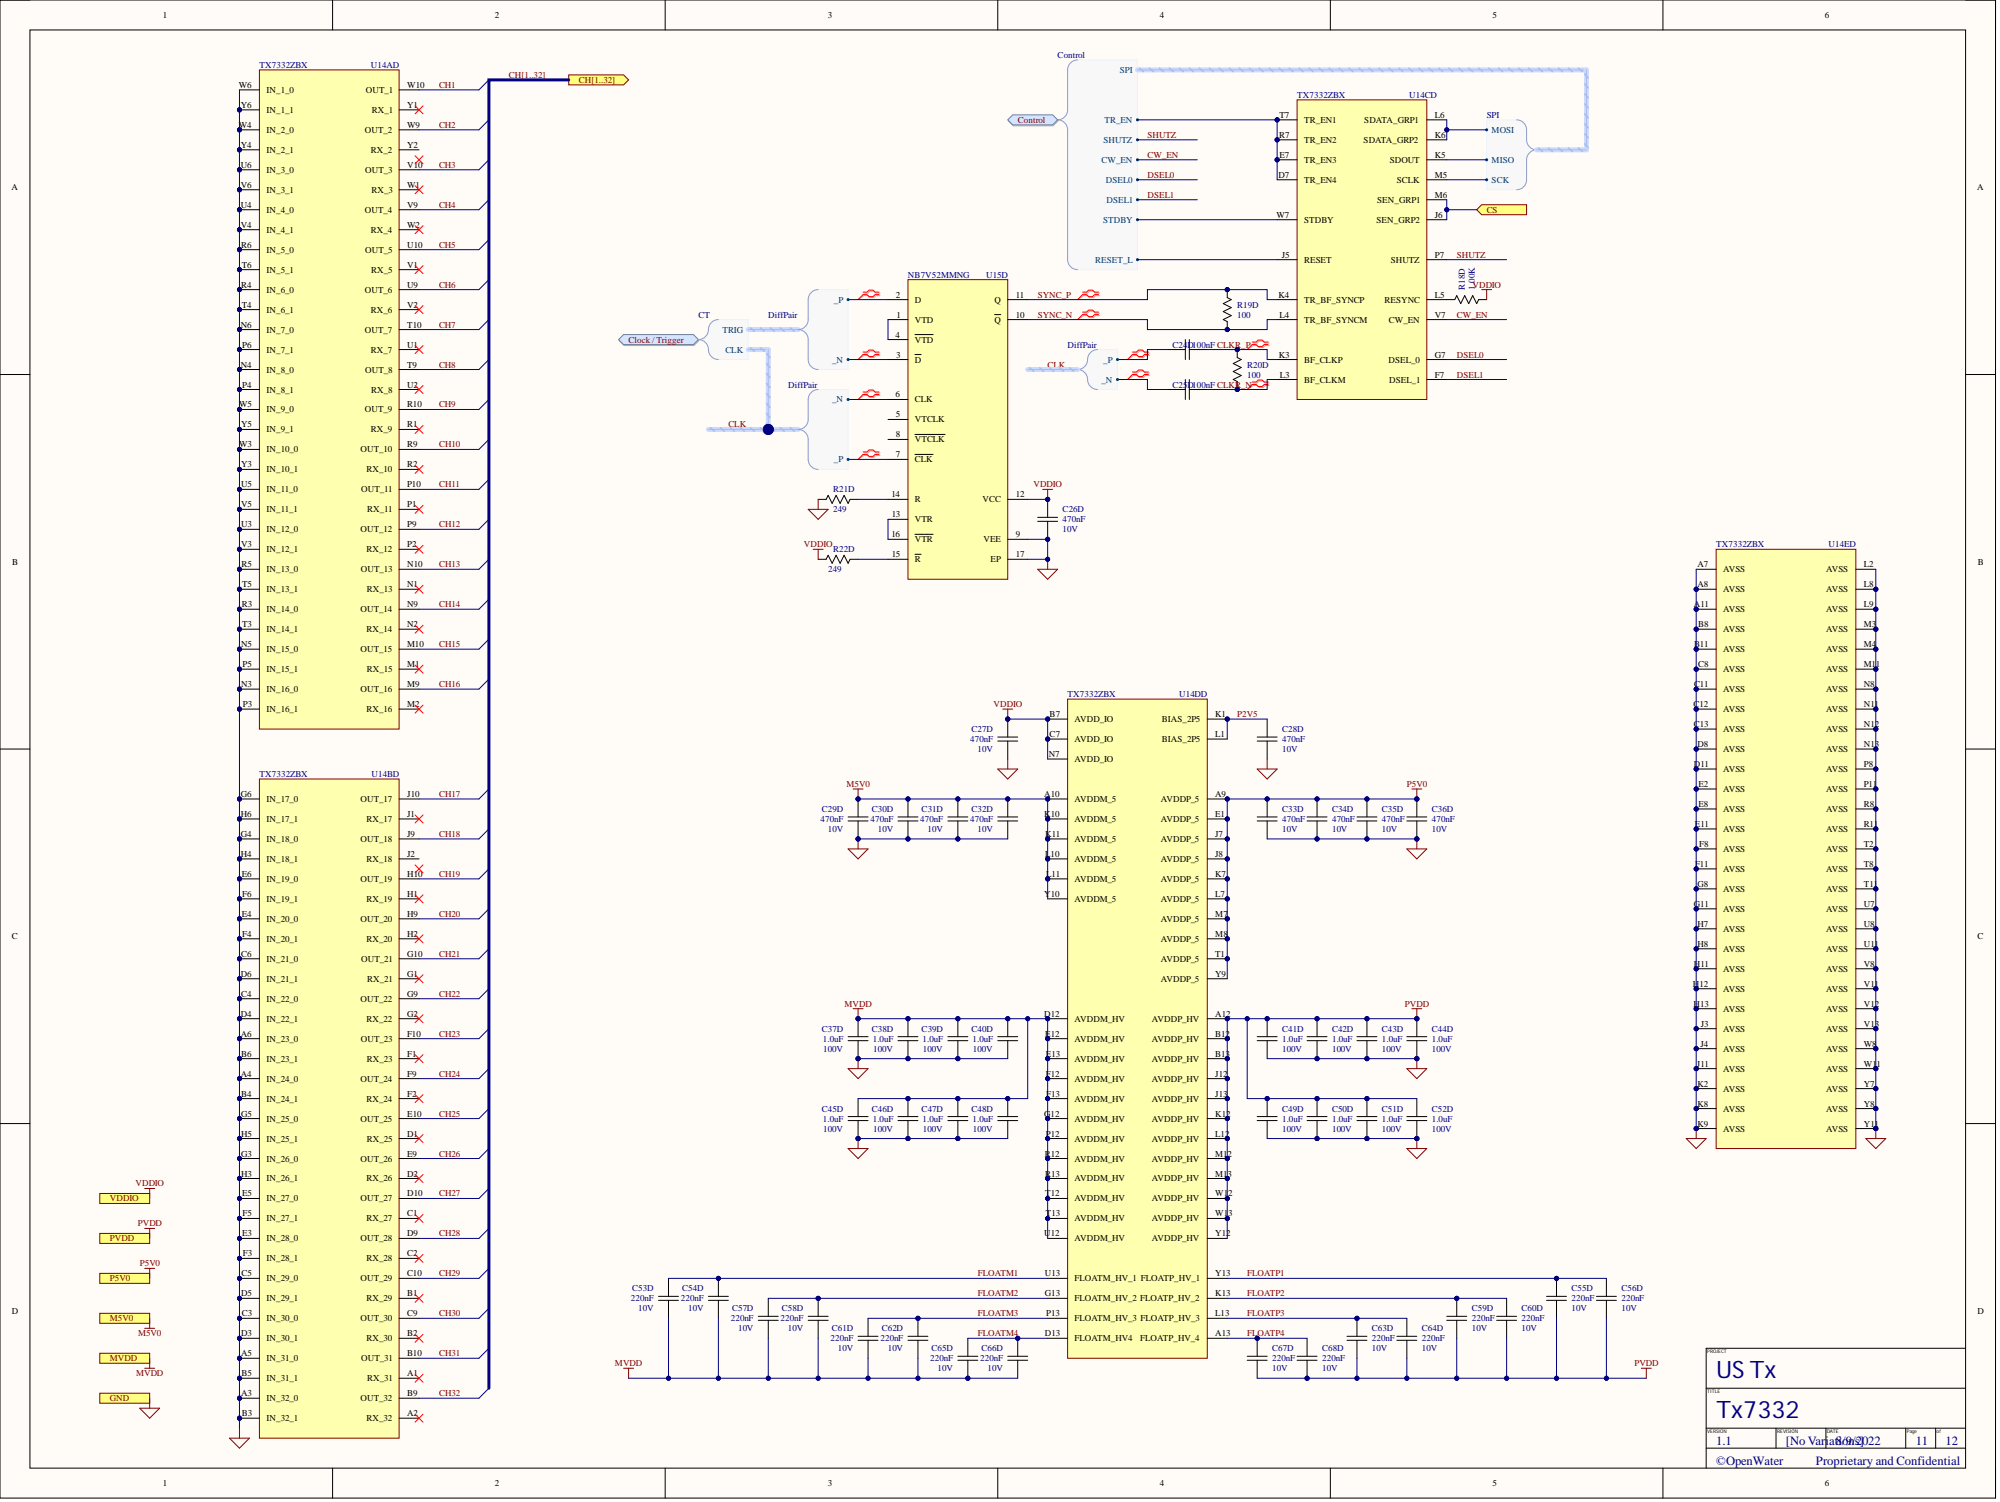
[picture p19: page 14]
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
