OpenwaterHealth/opw_ustx/hardware/Assembly Drawings_[No Variations].pdf

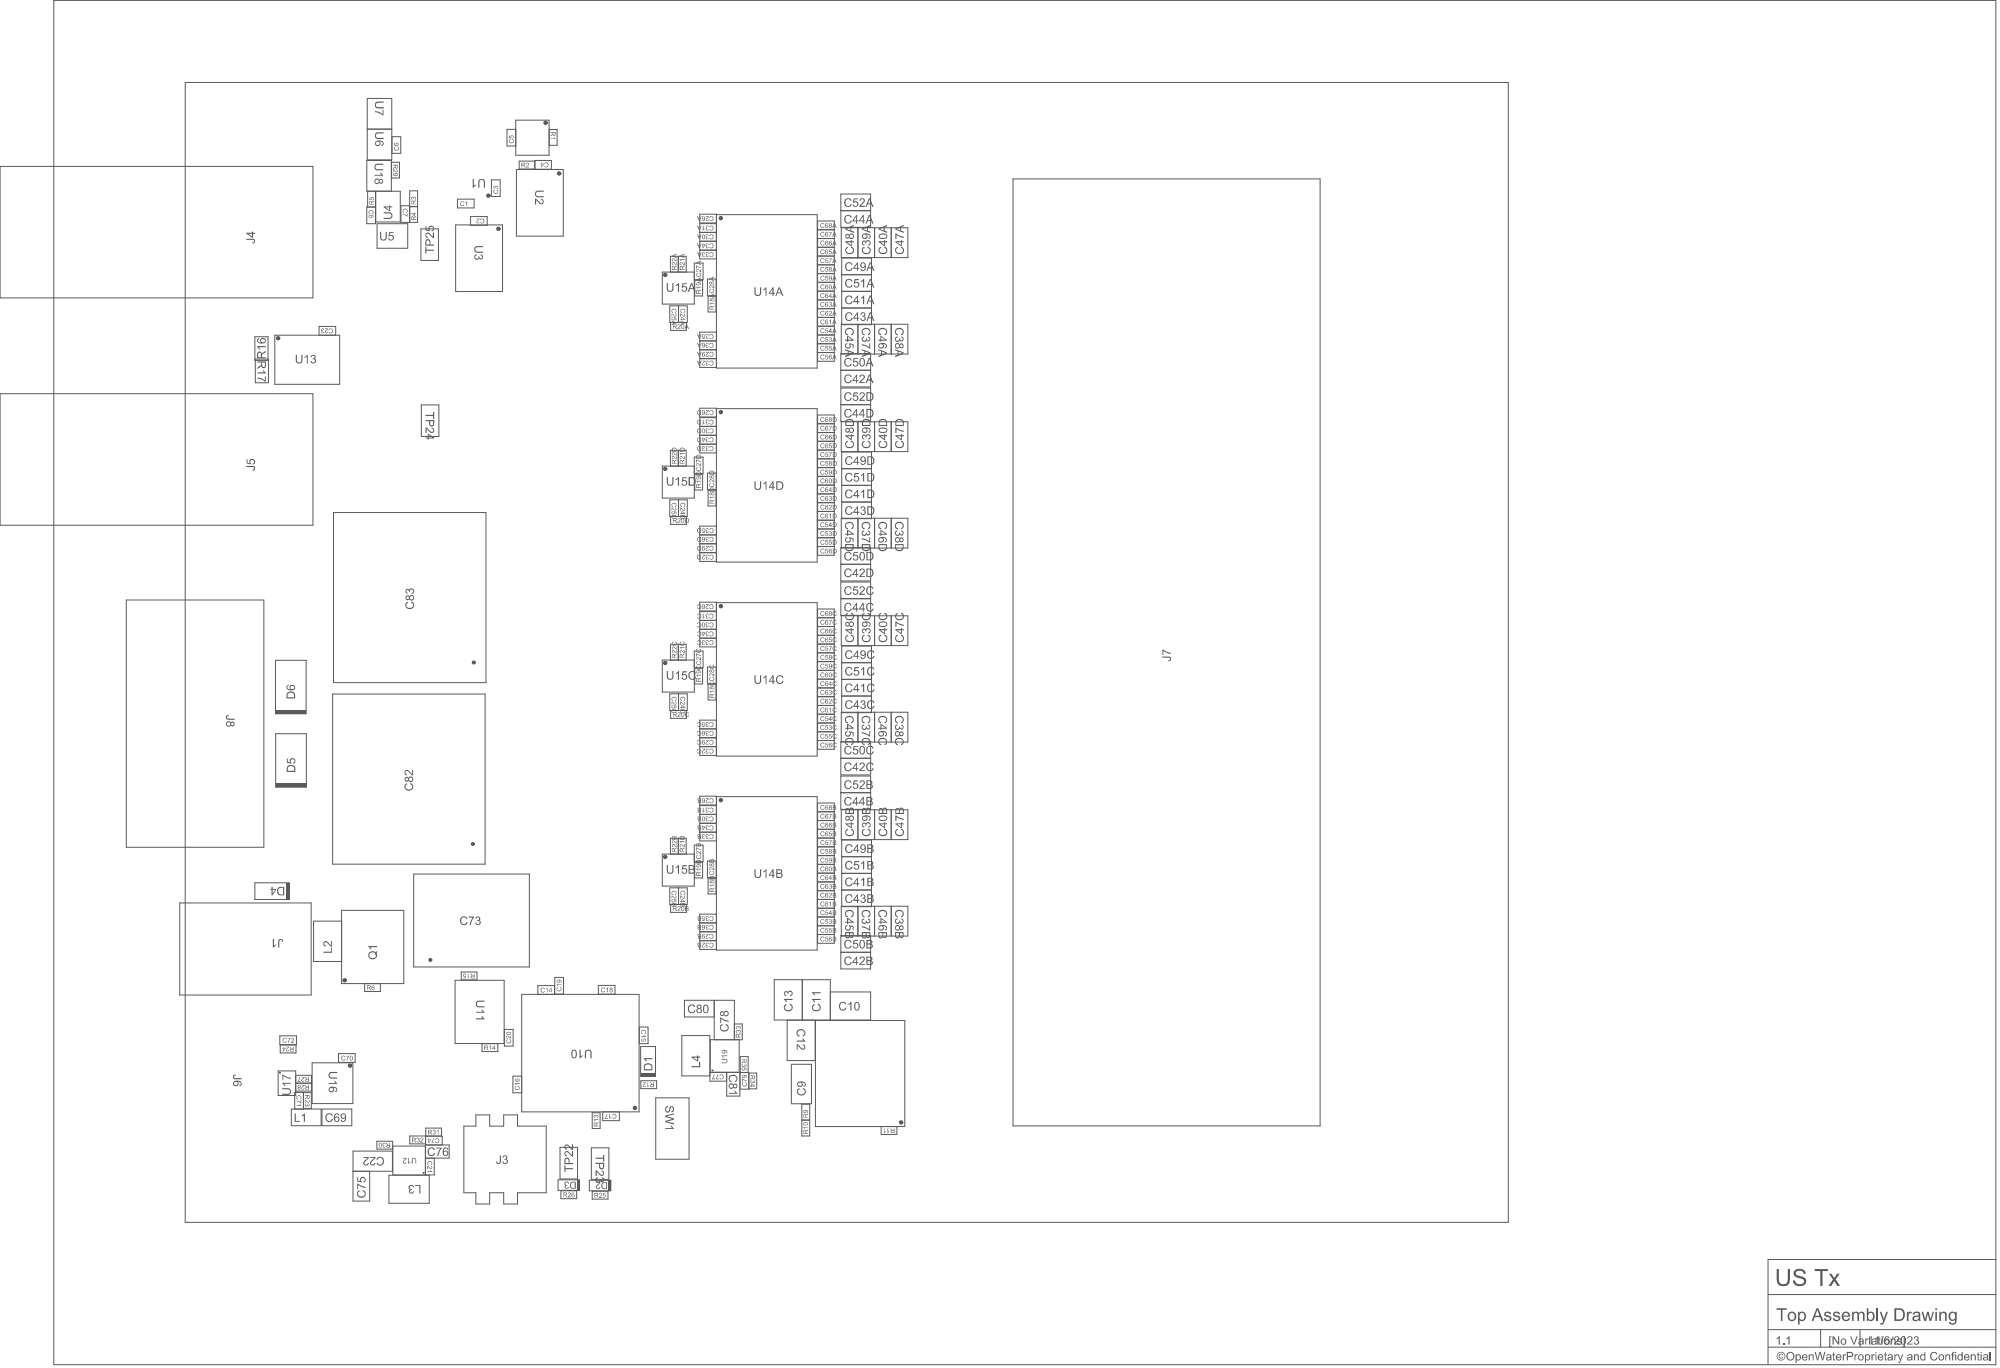
[picture p20: page 1]
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
