OpenwaterHealth/opw_ustx/embedded/Inc/main.h

#define CW_EN_Pin GPIO_PIN_2
#define CW_EN_GPIO_Port GPIOC
#define DRIVE1_Pin GPIO_PIN_1
#define DRIVE1_GPIO_Port GPIOA
#define DRIVE0_Pin GPIO_PIN_2
#define DRIVE0_GPIO_Port GPIOA
#define SHUTZ_Pin GPIO_PIN_3
#define SHUTZ_GPIO_Port GPIOA
#define TR_EN_Pin GPIO_PIN_4
#define TR_EN_GPIO_Port GPIOA
#define CS0_L_Pin GPIO_PIN_4
#define CS0_L_GPIO_Port GPIOC
#define CS1_L_Pin GPIO_PIN_5
#define CS1_L_GPIO_Port GPIOC
#define CS2_L_Pin GPIO_PIN_0
#define CS2_L_GPIO_Port GPIOB
#define CS3_L_Pin GPIO_PIN_1
#define CS3_L_GPIO_Port GPIOB
#define FLASH_CS_Pin GPIO_PIN_12
#define FLASH_CS_GPIO_Port GPIOB
#define SW_TRIG_Pin GPIO_PIN_6
#define SW_TRIG_GPIO_Port GPIOC
#define UART_RTS_Pin GPIO_PIN_12
#define UART_RTS_GPIO_Port GPIOA
#define TRIG_Pin GPIO_PIN_10
#define TRIG_GPIO_Port GPIOC
#define TRIG_EXTI_IRQn EXTI15_10_IRQn
#define LEDG_Pin GPIO_PIN_2
#define LEDG_GPIO_Port GPIOD
#define LEDR_Pin GPIO_PIN_6
#define LEDR_GPIO_Port GPIOB
