OpenwaterHealth/opw_ustx/(commit log)

2023-12-18 push 3
    yes
    [BOM_[No Variations].csv]
2023-12-18 re-organized repo
    [BOM_[No Variations].csv]
2023-12-19 added stm32 embedded source code
2024-07-22 Added Schematic to Repo
2026-10-09 Correct README disclaimer to remove investigational-device claim
